Chinmay3042001/Weighing-Scale-Coaster/Coaster HDD.odt

HDD for “Coaster”

1. Block diagram of the coaster system

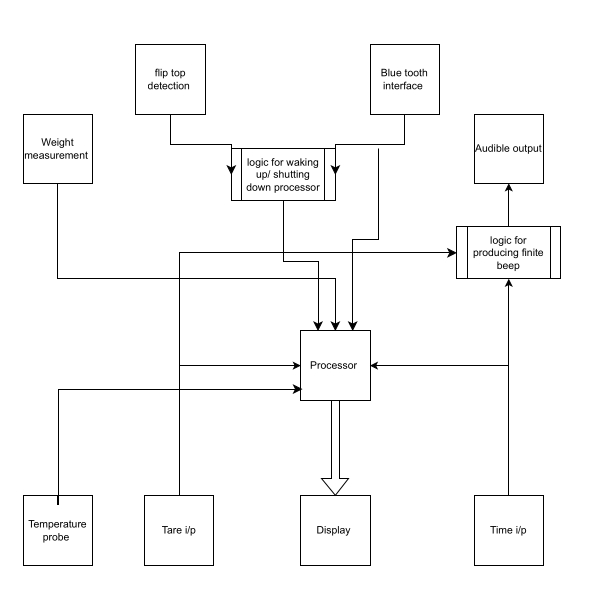
[picture p1: figure]

2. Requirements
  1. UI Inputs/Outputs :
    1. System should have two touch pads for the timer start and tare feature
    2. A flip top disc to start and shut down the system
    3. A dsiplay capable of conveying all details with required numeric precision as mandated by timing and weight measurement requirements
  2. Weight measurement
    1. Coaster shall be capable of weighing in the full scale range of 3000 grams
    2. Coaster shall be capable of weighing incremental changes of the order of 0.1 grams
    3. coaster shall have an acceptable error of 2% FS range.
  3. Temperature measurement requirements :
    1. The addon thermal probe in coaster shall be capable of measuring in a FS range of 0-110 deg C
    2. The thermal probe shall record data with minimum precision of 0.1deg C
    3. The tolerable error for the thermal probe shall be 1%
  4. Audio requirements
3. Design details
4. Source control

Weighing scale – “Coaster” Hardware design document
