Chinmay3042001/Weighing-Scale-Coaster/Weighing scale block diagram .drawio.pdf

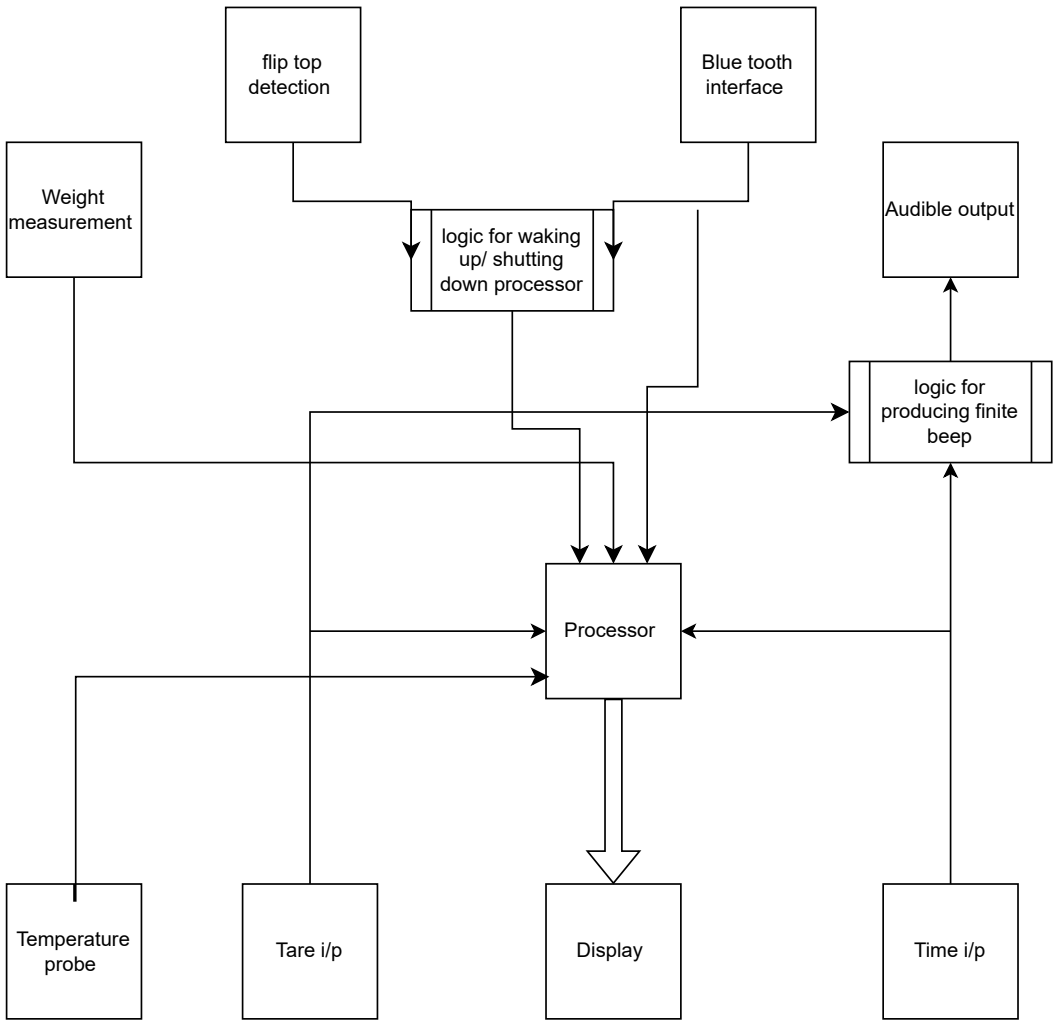
[picture p2: figure]
Processor; Tare i/p; Display; Time i/p; Audible output; flip top detection; Weight measurement; logic for producing finite beep; Temperature probe; Blue tooth interface; logic for waking up/ shutting; down processor
