Chinmay3042001/Weighing-Scale-Coaster/KiCAD/edge cuts for new mounting points.dxf

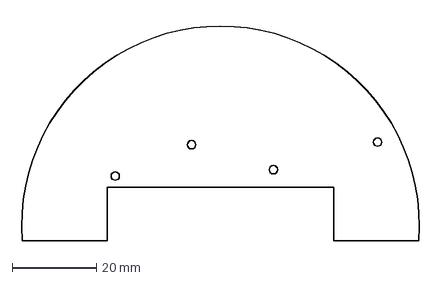
[picture p3: CAD file, 2025-10-31]
KiCAD/edge cuts for new mounting points.dxf
97.1 x 53.4 mm
