Chinmay3042001/Weighing-Scale-Coaster/KiCAD/WeighingScaleLibrary/LIB_74HC74D,653/74HC74D,653/3D/74HC74D,653.stp

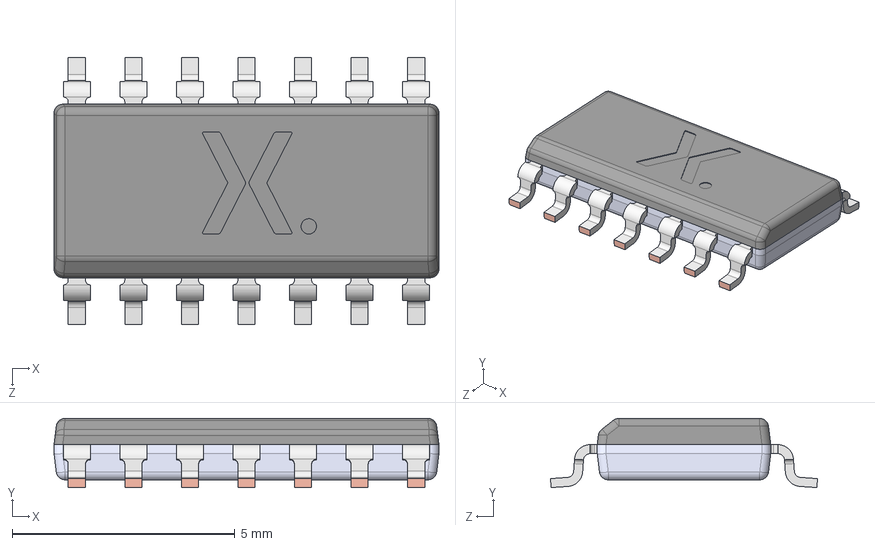
[picture p4: CAD file, 2025-10-02]
KiCAD/WeighingScaleLibrary/LIB_74HC74D,653/74HC74D,653/3D/74HC74D,653.stp
8.65 x 1.56 x 6.00 mm
SOT108 lower body
SOT108 upper body
SOT108-1 Lead
