Chinmay3042001/Weighing-Scale-Coaster/KiCAD/WeighingScaleLibrary/LIB_74LVC1G32W5-7/74LVC1G32W5-7/3D/74LVC1G32W5-7.stp

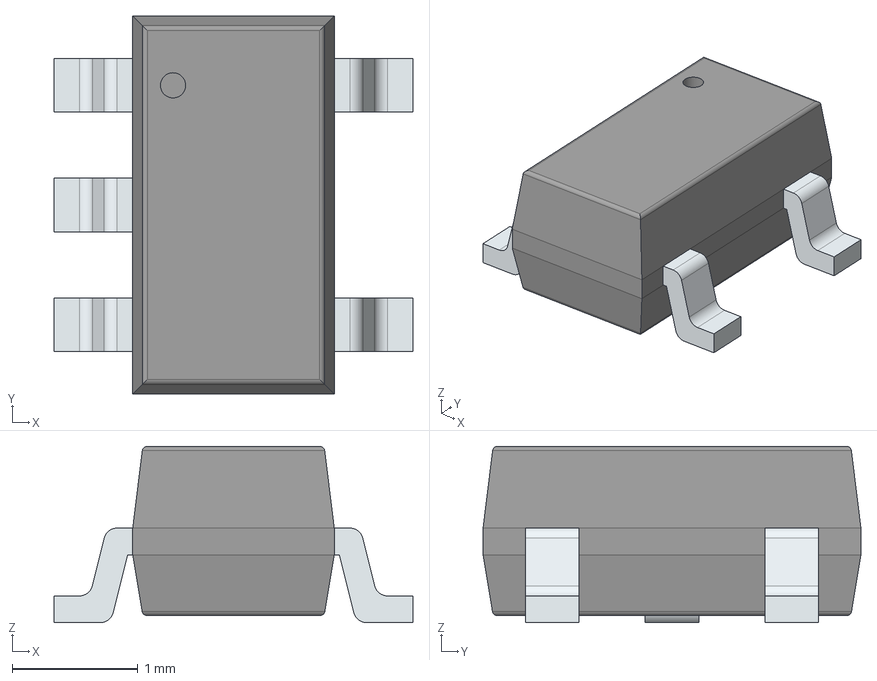
[picture p5: CAD file, 2026-01-18]
KiCAD/WeighingScaleLibrary/LIB_74LVC1G32W5-7/74LVC1G32W5-7/3D/74LVC1G32W5-7.stp
2.85 x 3.00 x 1.40 mm
PinsArrayL
PinsArrayR
