Chinmay3042001/Weighing-Scale-Coaster/KiCAD/WeighingScaleLibrary/LIB_CAP1203-1-SN/CAP1203-1-SN/3D/CAP1203-1-SN.stp

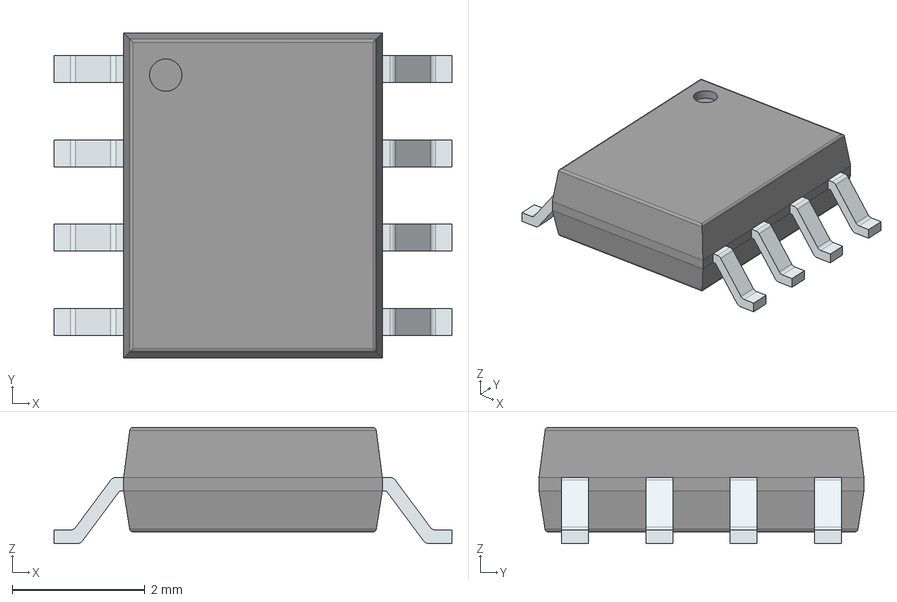
[picture p6: CAD file, 2025-12-10]
KiCAD/WeighingScaleLibrary/LIB_CAP1203-1-SN/CAP1203-1-SN/3D/CAP1203-1-SN.stp
6.00 x 4.90 x 1.75 mm
PinsArrayLR
