Chinmay3042001/Weighing-Scale-Coaster/KiCAD/WeighingScaleLibrary/LIB_JST_SM04B-SRSS-TB_LF__SN_/SM04B-SRSS-TB_LF__SN_/3D/SM04B-SRSS-TB_LF__SN_.stp

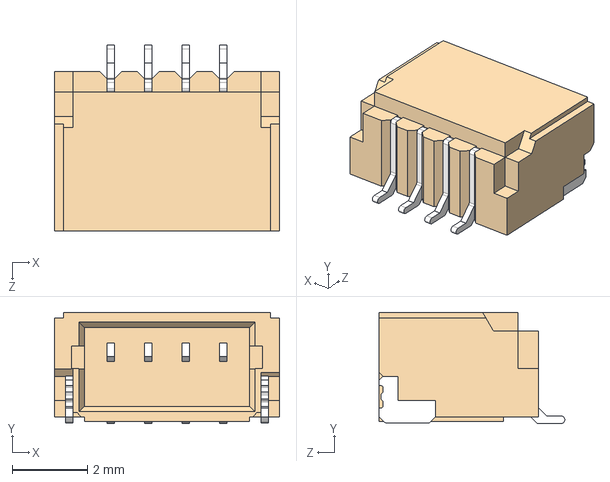
[picture p7: CAD file, 2025-10-10]
KiCAD/WeighingScaleLibrary/LIB_JST_SM04B-SRSS-TB_LF__SN_/SM04B-SRSS-TB_LF__SN_/3D/SM04B-SRSS-TB_LF__SN_.stp
6.00 x 2.96 x 4.95 mm
