Chinmay3042001/Weighing-Scale-Coaster/KiCAD/WeighingScaleLibrary/LIB_NX138AKR/NX138AKR.stp

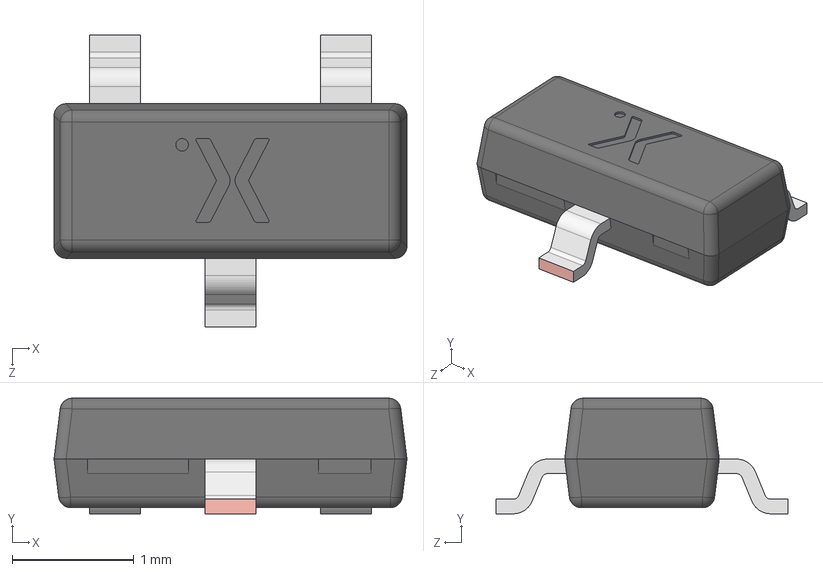
[picture p8: CAD file, 2025-10-28]
KiCAD/WeighingScaleLibrary/LIB_NX138AKR/NX138AKR.stp
2.90 x 0.95 x 2.40 mm
SOT23 lower body
SOT23 Lead x 3
SOT23 Upper body
