Chinmay3042001/Weighing-Scale-Coaster/KiCAD/WeighingScaleLibrary/LIB_PRT-12639 AUDIO/PRT-12639/3D/PRT-12639.stp

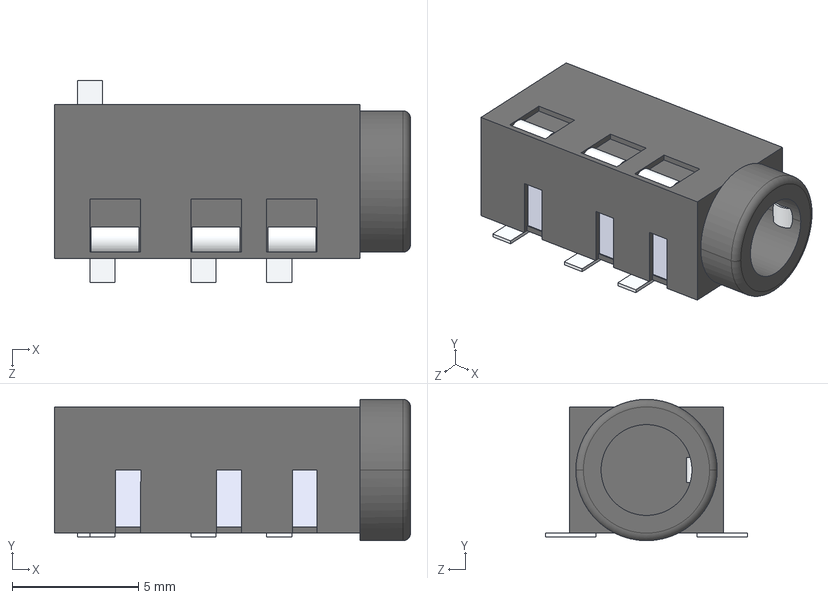
[picture p9: CAD file, 2025-10-10]
KiCAD/WeighingScaleLibrary/LIB_PRT-12639 AUDIO/PRT-12639/3D/PRT-12639.stp
14.1 x 5.60 x 8.00 mm
