Chinmay3042001/Weighing-Scale-Coaster/KiCAD/WeighingScaleLibrary/LIB_SFV14R-3STBE1HLF/SFV14R-3STBE1HLF/3D/SFV14R-3STBE1HLF.stp

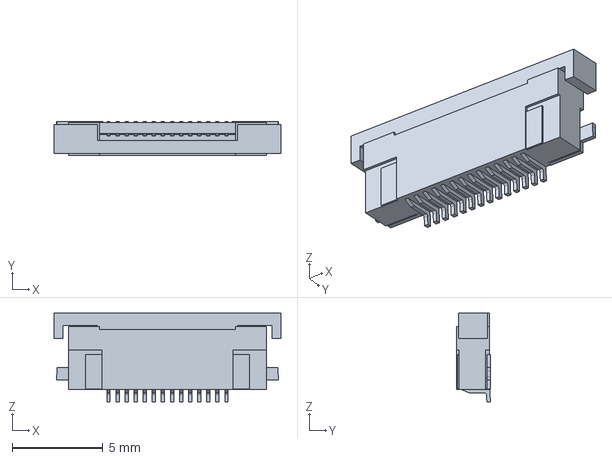
[picture p10: CAD file, 2025-10-04]
KiCAD/WeighingScaleLibrary/LIB_SFV14R-3STBE1HLF/SFV14R-3STBE1HLF/3D/SFV14R-3STBE1HLF.stp
12.5 x 1.87 x 4.90 mm
