Chinmay3042001/Weighing-Scale-Coaster/KiCAD/WeighingScaleLibrary/LIB_SN74LVC1G04DCKR/SN74LVC1G04DCKR/3D/SN74LVC1G04DCKR.stp

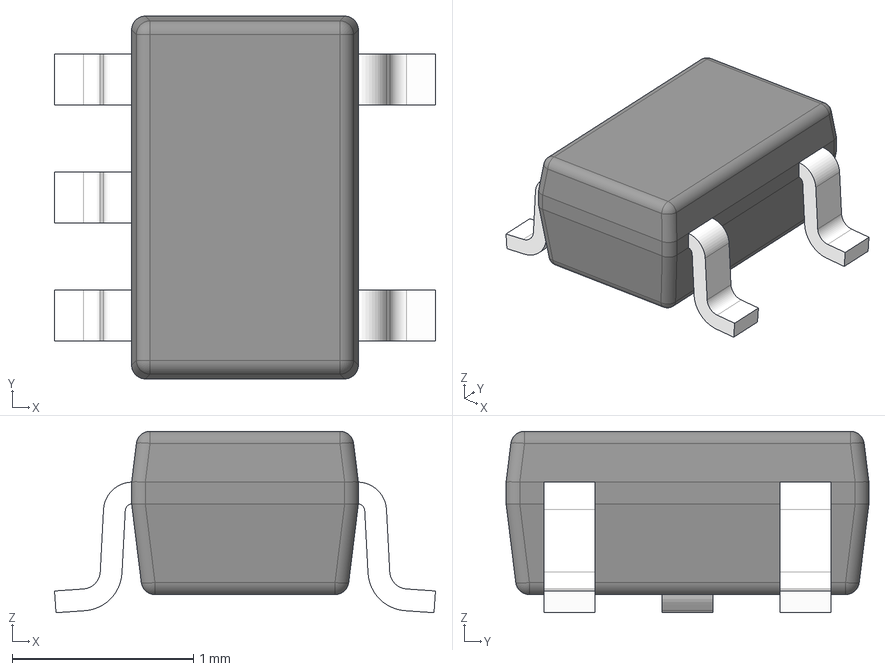
[picture p11: CAD file, 2025-10-10]
KiCAD/WeighingScaleLibrary/LIB_SN74LVC1G04DCKR/SN74LVC1G04DCKR/3D/SN74LVC1G04DCKR.stp
2.10 x 2.00 x 1.00 mm
BODY-SOT
LEAD-SOT x 5
PIN1-ID
