Chinmay3042001/Weighing-Scale-Coaster/KiCAD/WeighingScaleLibrary/LIB_SP720ABTG/SP720ABTG/3D/SP720ABTG.stp

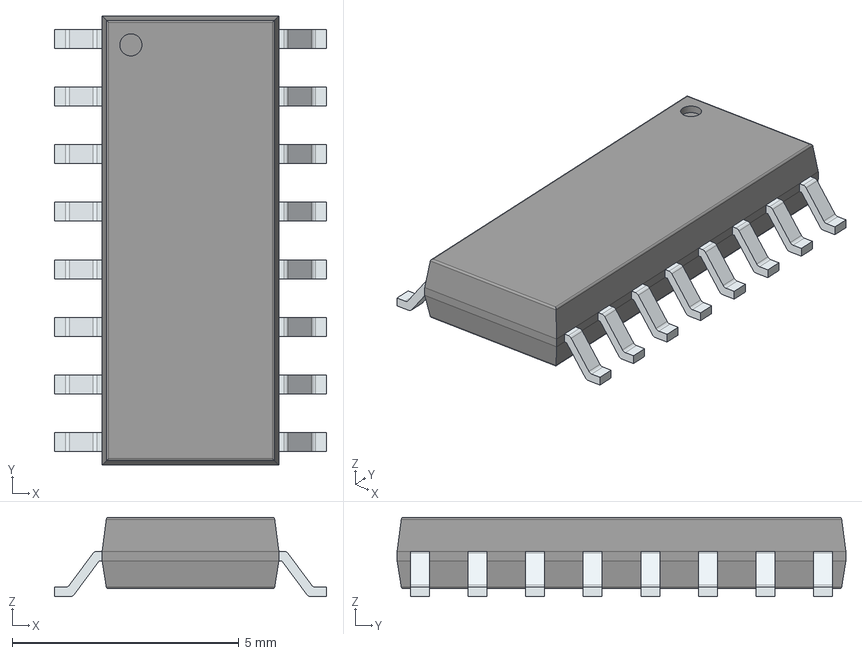
[picture p12: CAD file, 2025-10-01]
KiCAD/WeighingScaleLibrary/LIB_SP720ABTG/SP720ABTG/3D/SP720ABTG.stp
6.00 x 9.90 x 1.75 mm
PinsArrayLR
