Chinmay3042001/Weighing-Scale-Coaster/KiCAD/WeighingScaleLibrary/Library Files-20251007T151652Z-1-001/Library Files/seeedStudio_XIAO_Kicad/Seeed Studio XIAO ESP32-C6.step

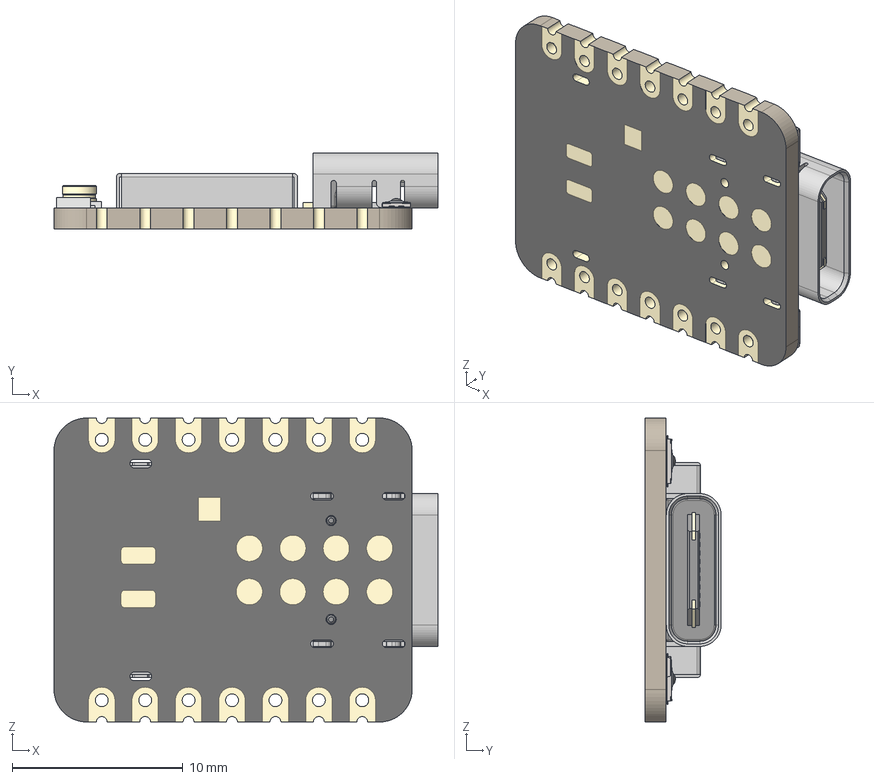
[picture p13: CAD file, 2025-10-10]
KiCAD/WeighingScaleLibrary/Library Files-20251007T151652Z-1-001/Library Files/seeedStudio_XIAO_Kicad/Seeed Studio XIAO ESP32-C6.step
22.5 x 4.46 x 17.8 mm
BOSS-EXTRUDE14_8_
BOSS-EXTRUDE7_4_
BOSS-EXTRUDE7_3_
BOSS-EXTRUDE14_4_
BOSS-EXTRUDE14_2_
BOSS-EXTRUDE14_11_
BOSS-EXTRUDE7_7_
BOSS-EXTRUDE14_9_
BOSS-EXTRUDE14_3_
BOSS-EXTRUDE14_7_
MIRROR2
BOSS-EXTRUDE14_5_
BOSS-EXTRUDE14_12_
BOSS-EXTRUDE7_8_
BOSS-EXTRUDE7_1_
BOSS-EXTRUDE14_10_
BOSS-EXTRUDE7_9_
BOSS-EXTRUDE14_6_
BOSS-EXTRUDE14_1_
BOSS-EXTRUDE7_6_
BOSS-EXTRUDE7_2_
CUT-EXTRUDE5
BOSS-EXTRUDE7_5_
U.FL Connector v1
Shield
SKTAAAE010 x 2
KH5220-A36 (Ceramic Antenna) v2
