Chinmay3042001/Weighing-Scale-Coaster/KiCAD/WeighingScaleLibrary/Library Files-20251007T151652Z-1-001/Library Files/TTP223-BA6 (1)/TTP223-BA6.step

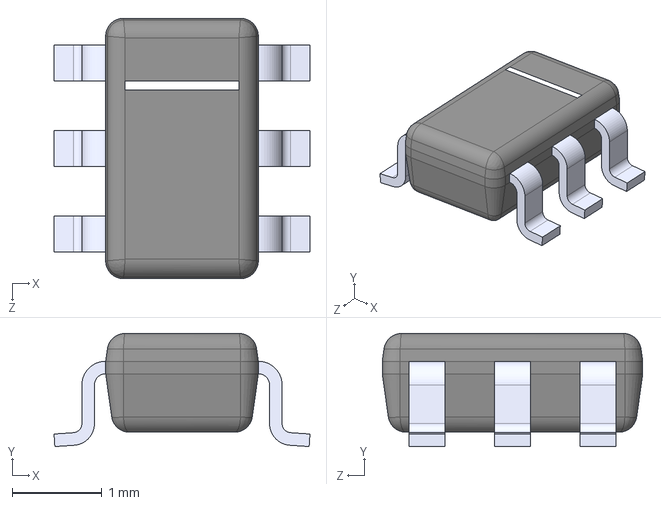
[picture p14: CAD file, 2025-10-10]
KiCAD/WeighingScaleLibrary/Library Files-20251007T151652Z-1-001/Library Files/TTP223-BA6 (1)/TTP223-BA6.step
2.85 x 1.26 x 2.90 mm
