Chinmay3042001/Weighing-Scale-Coaster/KiCAD/DXF no center marks.dxf

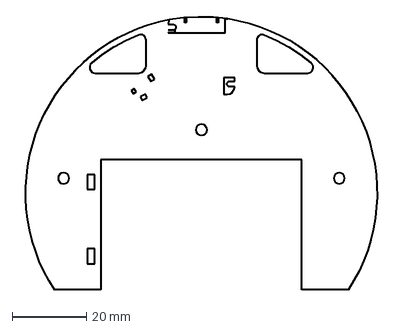
[picture p15: CAD file, 2025-10-18]
KiCAD/DXF no center marks.dxf
99.5 x 73.6 mm
