Chinmay3042001/Weighing-Scale-Coaster/KiCAD/touchpad_boundary.dxf

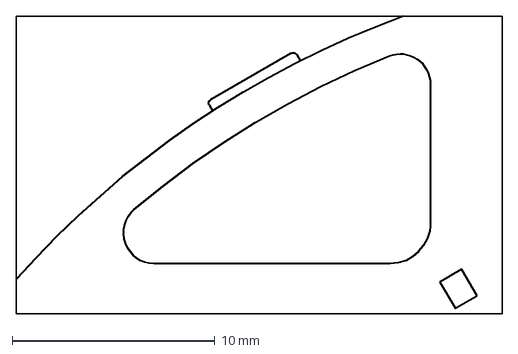
[picture p16: CAD file, 2025-10-18]
KiCAD/touchpad_boundary.dxf
24.0 x 14.7 mm
