Chinmay3042001/Weighing-Scale-Coaster/KiCAD/placement guide.dxf

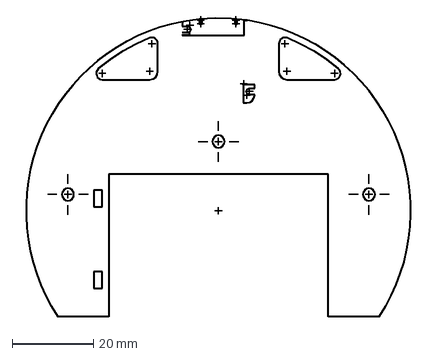
[picture p17: CAD file, 2025-10-06]
KiCAD/placement guide.dxf
99.5 x 73.7 mm
