Chinmay3042001/Weighing-Scale-Coaster/KiCAD/card_edge.dxf

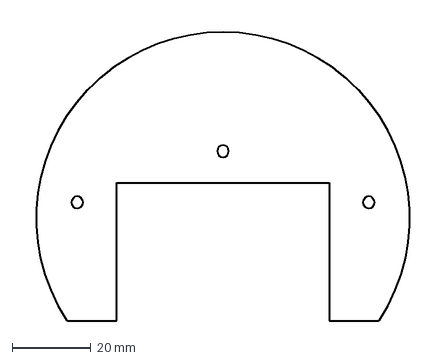
[picture p18: CAD file, 2025-10-06]
KiCAD/card_edge.dxf
105.0 x 77.2 mm
