Chinmay3042001/Weighing-Scale-Coaster/(list of files, cad)

Other CAD files:
KiCAD/WeighingScaleLibrary/LIB_MAX6675ISA+T/MAX6675ISA+T/3D/MAX6675ISA+T.stp
KiCAD/WeighingScaleLibrary/Library Files-20251007T151652Z-1-001/Library Files/LIB_MAX6675ISA+T/MAX6675ISA+T/3D/MAX6675ISA+T.stp
KiCAD/WeighingScaleLibrary/TTP223-BA6--3DModel-STEP-269445.STEP
KiCAD/WeighingScaleLibrary/LIB_74HC74D,653/74HC74D,653/Allegro/soic127p600x175-14n.psm
KiCAD/WeighingScaleLibrary/LIB_74HC74D,653/74HC74D,653/DEHDL/74hc74d_653/chips/chips.prt
KiCAD/WeighingScaleLibrary/LIB_74LVC1G08GW/74LVC1G08GW/Allegro/sot65p212x110-5n.psm
KiCAD/WeighingScaleLibrary/LIB_74LVC1G08GW/74LVC1G08GW/DEHDL/74lvc1g08gw/chips/chips.prt
KiCAD/WeighingScaleLibrary/LIB_74LVC1G32W5-7/74LVC1G32W5-7/Allegro/sot95p285x140-5n.psm
KiCAD/WeighingScaleLibrary/LIB_74LVC1G32W5-7/74LVC1G32W5-7/DEHDL/74lvc1g32w5_7/chips/chips.prt
KiCAD/WeighingScaleLibrary/LIB_74LVC1G79GW,125/74LVC1G79GW,125/Allegro/sot65p212x110-5n.psm
KiCAD/WeighingScaleLibrary/LIB_74LVC1G79GW,125/74LVC1G79GW,125/DEHDL/74lvc1g79gw_125/chips/chips.prt
KiCAD/WeighingScaleLibrary/LIB_APS11753KMDALX-9PL5/APS11753KMDALX-9PL5/3D/APS11753KMDALX-9PL5.stp
KiCAD/WeighingScaleLibrary/LIB_CAP1203-1-SN/CAP1203-1-SN/Allegro/soic127p600x175-8n.psm
KiCAD/WeighingScaleLibrary/LIB_CAP1203-1-SN/CAP1203-1-SN/DEHDL/cap1203_1_sn/chips/chips.prt
KiCAD/WeighingScaleLibrary/LIB_NX138AKR (2)/NX138AKR/Allegro/sot95p230x110-3n.psm
KiCAD/WeighingScaleLibrary/LIB_NX138AKR (2)/NX138AKR/DEHDL/nx138akr/chips/chips.prt
KiCAD/WeighingScaleLibrary/LIB_SFV14R-3STBE1HLF/SFV14R-3STBE1HLF/Allegro/sfv14r3stbe1hlf.psm
KiCAD/WeighingScaleLibrary/LIB_SFV14R-3STBE1HLF/SFV14R-3STBE1HLF/DEHDL/sfv14r_3stbe1hlf/chips/chips.prt
KiCAD/WeighingScaleLibrary/LIB_SN74LVC1G04DCKR/SN74LVC1G04DCKR/Allegro/sot65p210x110-5n.psm
KiCAD/WeighingScaleLibrary/LIB_SN74LVC1G04DCKR/SN74LVC1G04DCKR/DEHDL/sn74lvc1g04dckr/chips/chips.prt
KiCAD/WeighingScaleLibrary/LIB_SP720ABTG/SP720ABTG/Allegro/soic127p600x175-16n.psm
KiCAD/WeighingScaleLibrary/LIB_SP720ABTG/SP720ABTG/DEHDL/sp720abtg/chips/chips.prt
KiCAD/WeighingScaleLibrary/Library Files-20251007T151652Z-1-001/Library Files/LIB_APS11753KMDALX-9PL5/APS11753KMDALX-9PL5/3D/APS11753KMDALX-9PL5.stp
