Chinmay3042001/Weighing-Scale-Coaster/KiCAD/ws_schematic_draft1.pdf

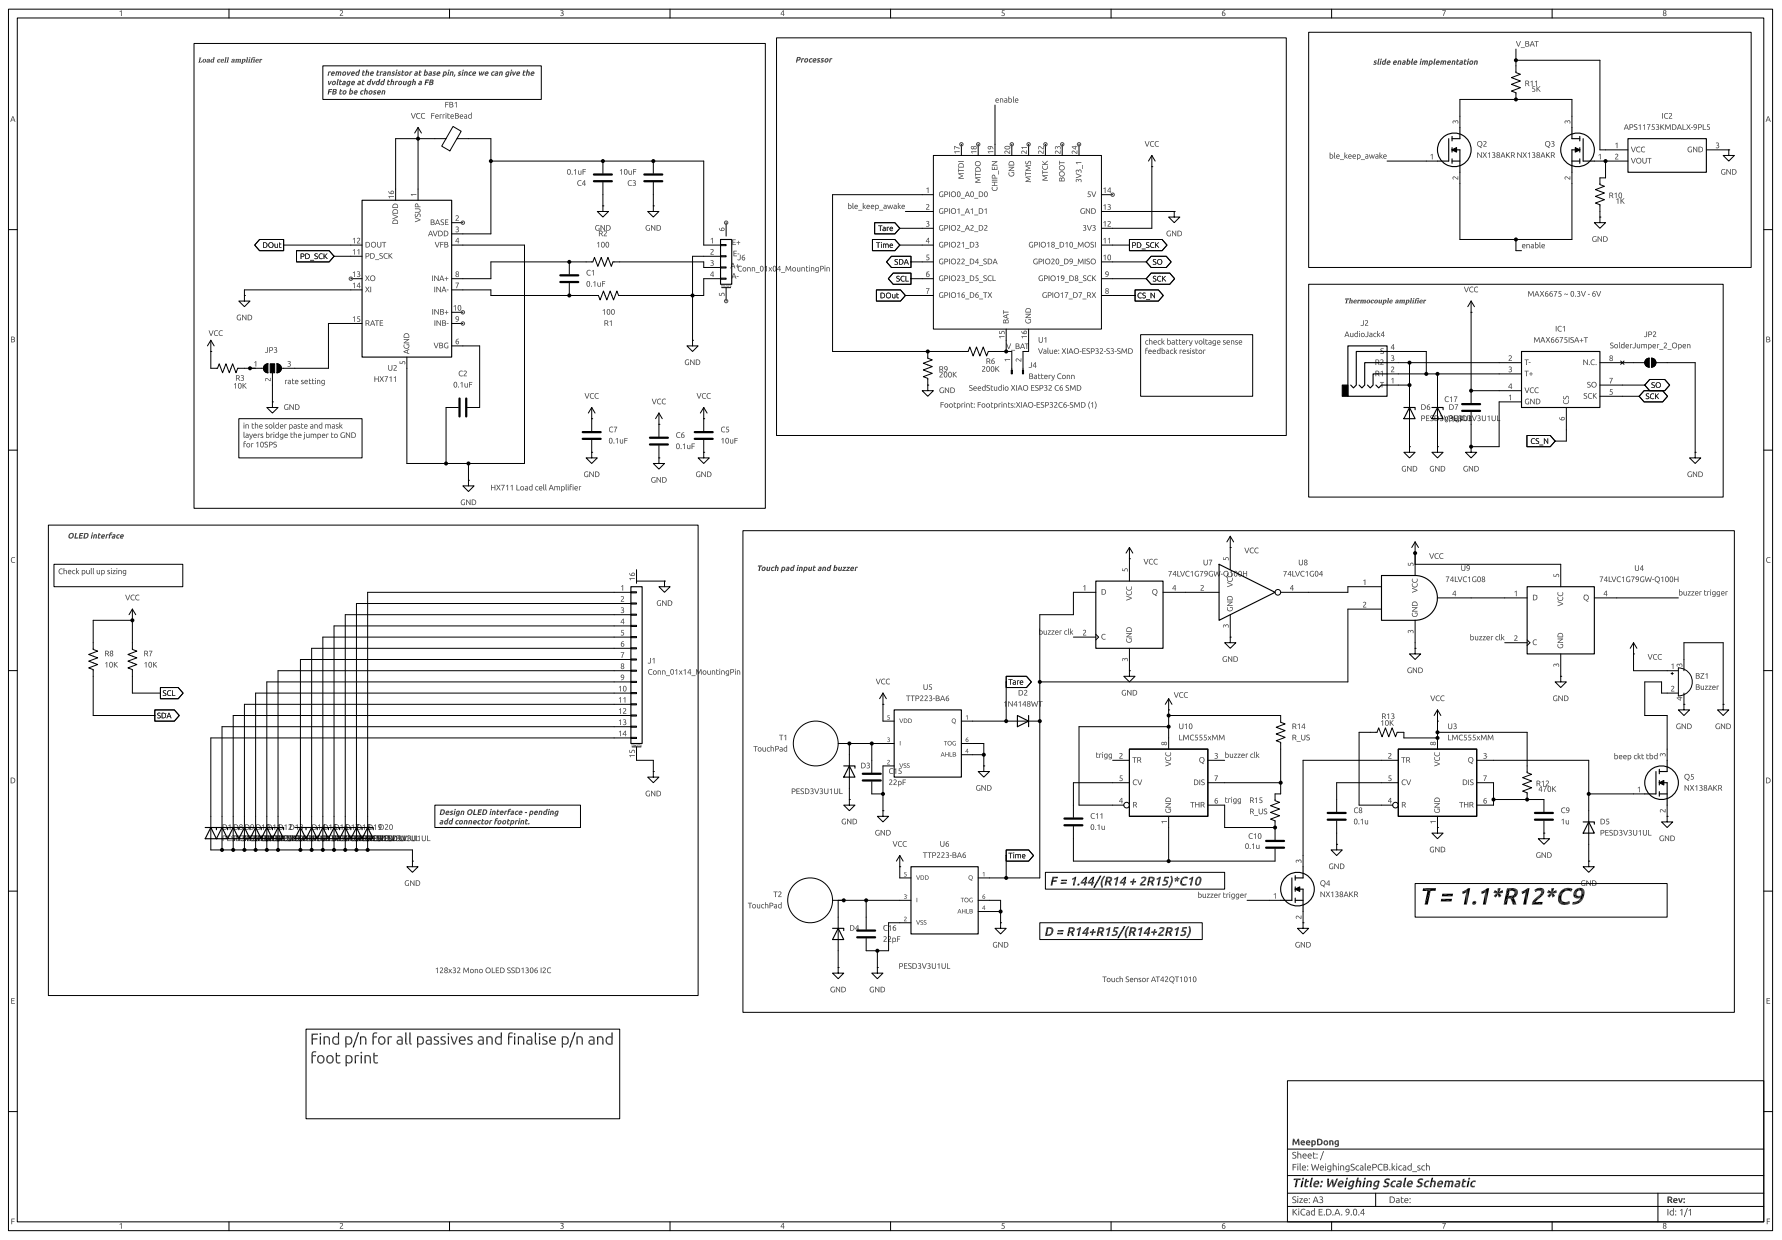
[picture p19: page 1]
