Chinmay3042001/Weighing-Scale-Coaster/(list of files, drawings)

Other design files:
KiCAD/WeighingScaleLibrary/LIB_74HC74D,653/74HC74D,653/Altium/74HC74D_653.SchLib
KiCAD/WeighingScaleLibrary/LIB_74HC74D,653/74HC74D,653/Altium/SOIC127P600X175-14N.PcbLib
KiCAD/WeighingScaleLibrary/LIB_74LVC1G08GW/74LVC1G08GW/Altium/74LVC1G08GW.SchLib
KiCAD/WeighingScaleLibrary/LIB_74LVC1G08GW/74LVC1G08GW/Altium/SOT65P212X110-5N.PcbLib
KiCAD/WeighingScaleLibrary/LIB_74LVC1G32W5-7/74LVC1G32W5-7/Altium/74LVC1G32W5-7.SchLib
KiCAD/WeighingScaleLibrary/LIB_74LVC1G32W5-7/74LVC1G32W5-7/Altium/SOT95P285X140-5N.PcbLib
KiCAD/WeighingScaleLibrary/LIB_74LVC1G79GW,125/74LVC1G79GW,125/Altium/74LVC1G79GW_125.SchLib
KiCAD/WeighingScaleLibrary/LIB_74LVC1G79GW,125/74LVC1G79GW,125/Altium/SOT65P212X110-5N.PcbLib
KiCAD/WeighingScaleLibrary/LIB_CAP1203-1-SN/CAP1203-1-SN/Altium/CAP1203-1-SN.SchLib
KiCAD/WeighingScaleLibrary/LIB_CAP1203-1-SN/CAP1203-1-SN/Altium/SOIC127P600X175-8N.PcbLib
KiCAD/WeighingScaleLibrary/LIB_NX138AKR (2)/NX138AKR/Altium/NX138AKR.SchLib
KiCAD/WeighingScaleLibrary/LIB_NX138AKR (2)/NX138AKR/Altium/SOT95P230X110-3N.PcbLib
KiCAD/WeighingScaleLibrary/LIB_SFV14R-3STBE1HLF/SFV14R-3STBE1HLF/Altium/SFV14R3STBE1HLF.PcbLib
KiCAD/WeighingScaleLibrary/LIB_SFV14R-3STBE1HLF/SFV14R-3STBE1HLF/Altium/SFV14R-3STBE1HLF.SchLib
KiCAD/WeighingScaleLibrary/LIB_SN74LVC1G04DCKR/SN74LVC1G04DCKR/Altium/SN74LVC1G04DCKR.SchLib
KiCAD/WeighingScaleLibrary/LIB_SN74LVC1G04DCKR/SN74LVC1G04DCKR/Altium/SOT65P210X110-5N.PcbLib
KiCAD/WeighingScaleLibrary/LIB_SP720ABTG/SP720ABTG/Altium/SOIC127P600X175-16N.PcbLib
KiCAD/WeighingScaleLibrary/LIB_SP720ABTG/SP720ABTG/Altium/SP720ABTG.SchLib
