Chinmay3042001/Weighing-Scale-Coaster/KiCAD/WeighingScalePCB/WeighingScalePCB.kicad_pcb

## KiCad design KiCAD/WeighingScalePCB/WeighingScalePCB.kicad_pcb (2026-01-18)

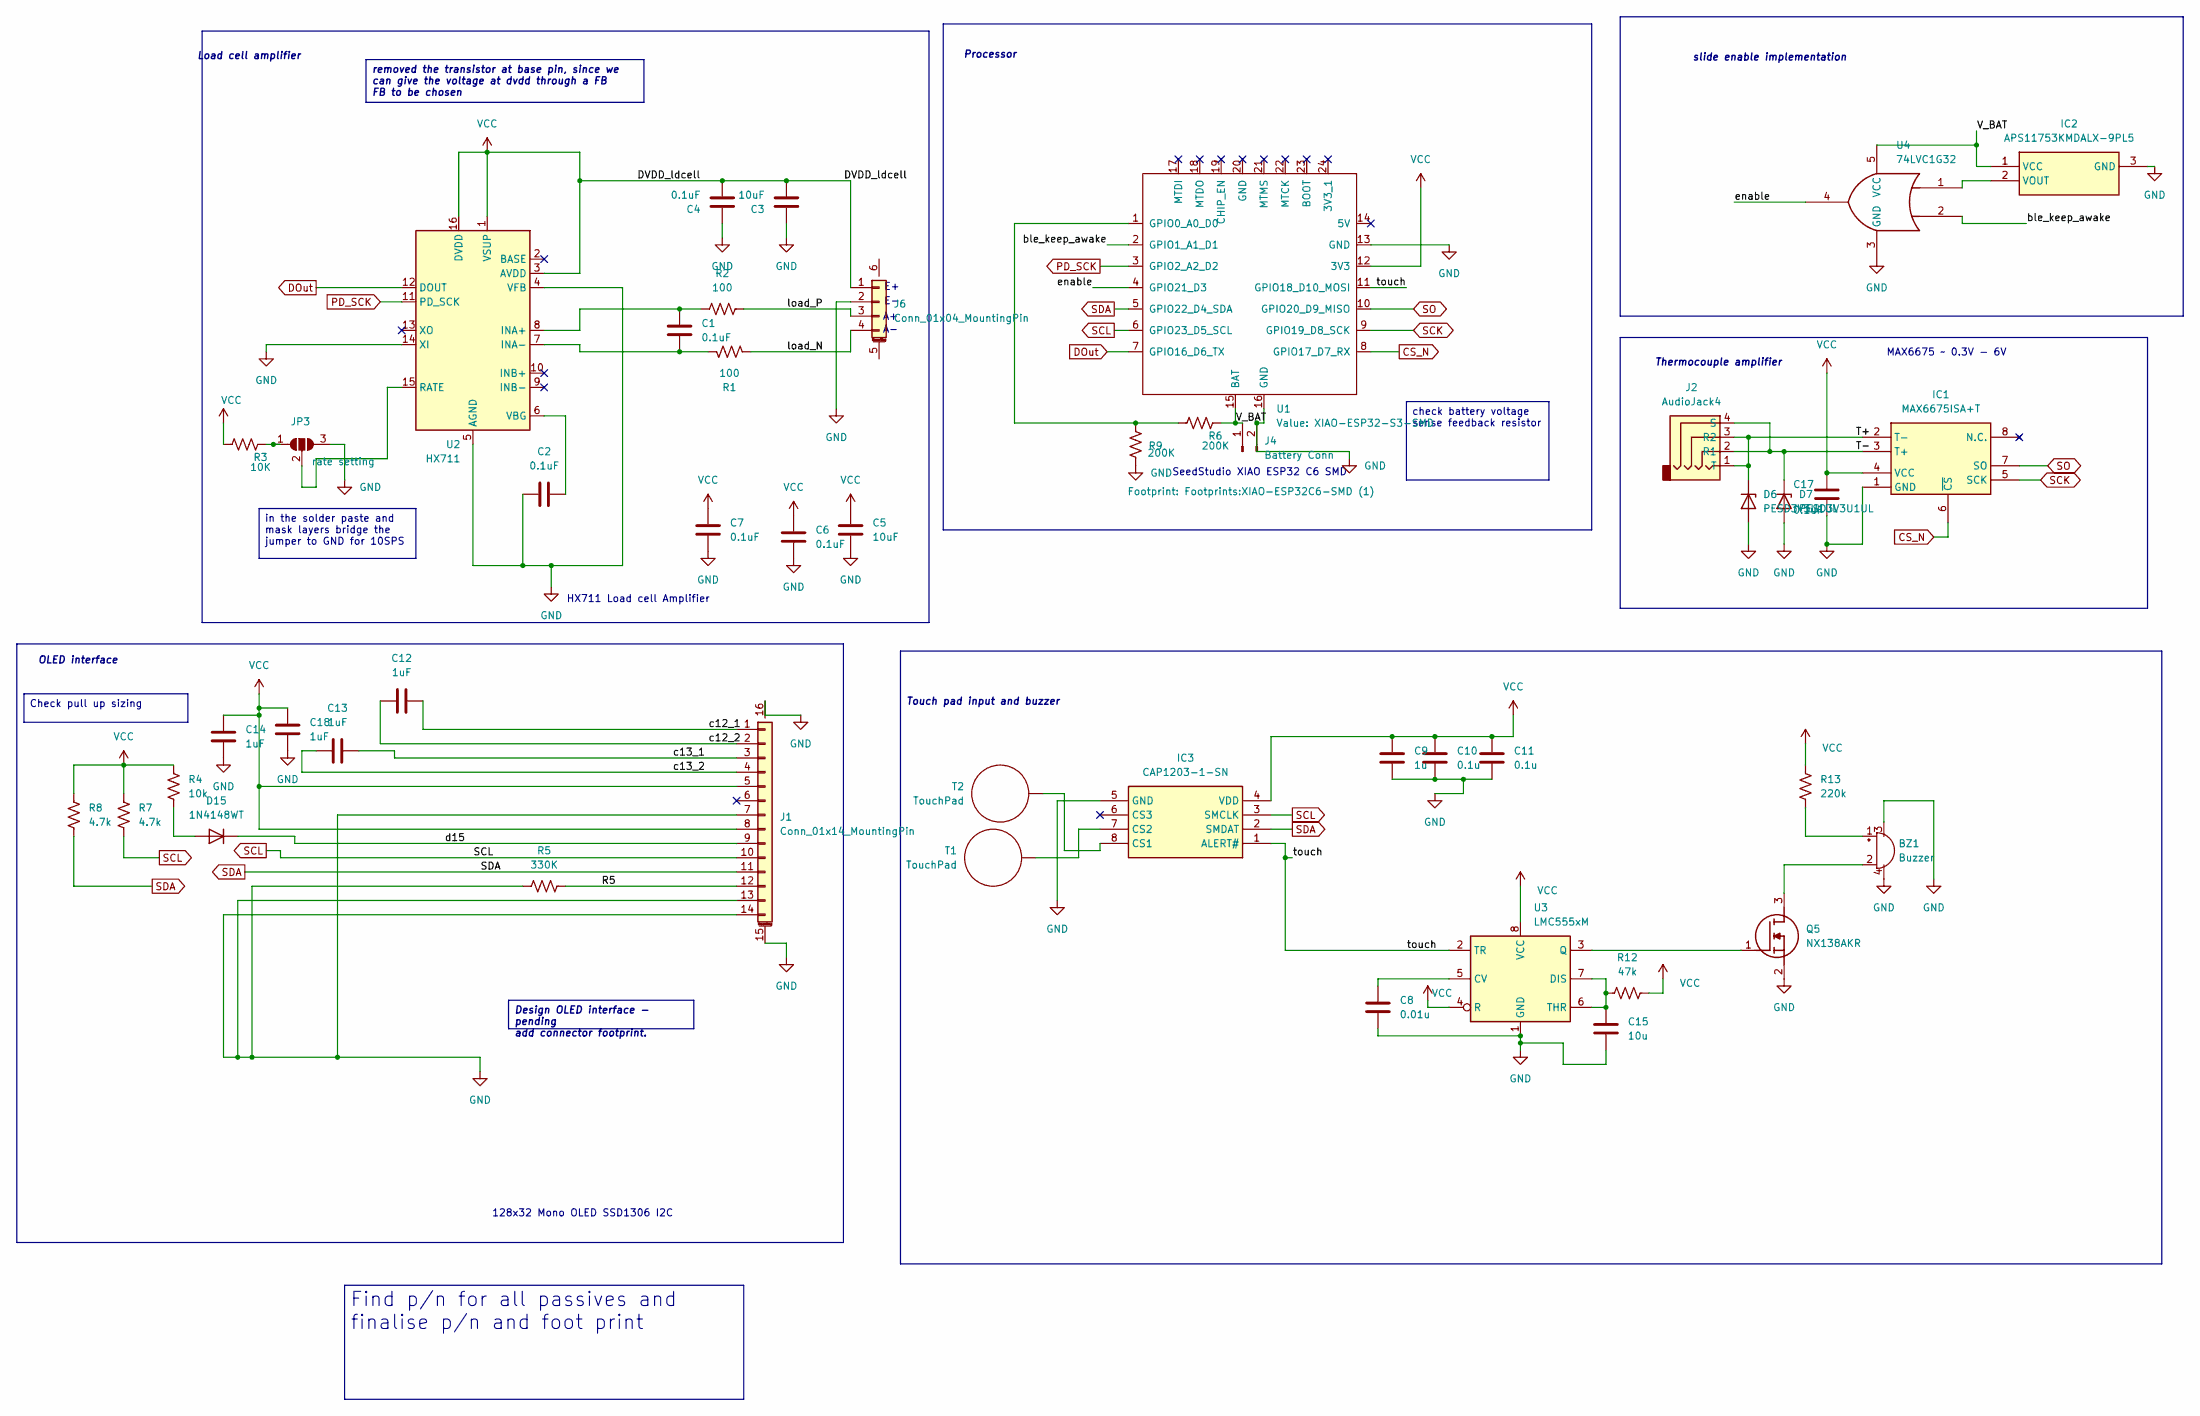
[picture p20: schematic WeighingScalePCB.kicad_sch, Weighing Scale Schematic]

Parts:
BZ1: Buzzer; CL7525A_buzzer
C1, C2, C4, C6, C7, C17: 0.1uF; C_0603_1608Metric
C3, C5: 10uF; C_0603_1608Metric
C8: 0.01u; C_0603_1608Metric
C9: 1u; C_0603_1608Metric
C10, C11: 0.1u; C_0603_1608Metric
C12, C13, C14, C18: 1uF; C_0603_1608Metric
C15: 10u; C_0603_1608Metric
D6, D7: PESD3V3U1UL; D_SOD-882
D15: 1N4148WT; D_SOD-523
IC1: MAX6675ISA+T; SOIC127P600X175-8N_MAX6675; Mouser Part Number 700-MAX6675ISAT
IC2: APS11753KMDALX-9PL5; SOT95P240X115-3N_Hall effect; Mouser Part Number 250-APS11753KMD-9PL5
IC3: CAP1203-1-SN; CAP1203_SOIC127P600X175-8N; Mouser Part Number 579-CAP1203-1-SN
J1: Conn_01x14_MountingPin; SFV14R3STBE1HLF_oled_conn
J2: AudioJack4; PRT12639_thermocouple_conn
J4: Battery Conn; PinHeader_2x01_P2.00mm_Vertical_SMD
J6: Conn_01x04_MountingPin; SM04B-SRSS-TB_LFSN_
JP3: rate setting; SolderJumper-3_P1.3mm_Open_RoundedPad1.0x1.5mm
Q5: NX138AKR; SOT95P230X110-3N; Mouser Part Number 771-NX138AKR
R1, R2: 100; R_0603_1608Metric
R3: 10K; R_0603_1608Metric
R4: 10k; R_0402_1005Metric
R5: 330K; R_0402_1005Metric
R6, R9: 200K; R_0603_1608Metric
R7, R8: 4.7k; R_0603_1608Metric
R12: 47k; R_0603_1608Metric
R13: 220k; R_0603_1608Metric
T1: TouchPad; touchpad
T2: TouchPad; touchpad 2
U1: XIAO-ESP32-S3-SMD; XIAO-ESP32C6-SMD (1)
U2: HX711; SOIC-16_3.9x9.9mm_P1.27mm
U3: LMC555xM; SOIC-8_3.9x4.9mm_P1.27mm
U4: 74LVC1G32; SOT95P285X140-5N

Connections:
/R5: J1.12, R5.2
/T+: D6.1 (K), IC1.2 (T-), J2.1 (T), J2.3 (R2)
/T-: D7.1 (K), IC1.3 (T+), J2.2 (R1), J2.4 (S)
/V_BAT: IC2.1 (VCC), J4.1, R6.1, U1.15 (BAT), U4.5 (VCC)
/ble_keep_awake: U1.2 (GPIO1_A1_D1), U4.2
/c12_1: C12.2, J1.1
/c12_2: C12.1, J1.2
/c13_1: C13.2, J1.3
/c13_2: C13.1, J1.4
/d15: D15.1 (K), J1.9
/enable: U1.4 (GPIO21_D3), U4.4
/load_N: J6.4, R1.1
/load_P: J6.3, R2.1
/touch: IC3.1 (ALERT#), U1.11 (GPIO18_D10_MOSI), U3.2 (TR)
CS_N: IC1.6 (~CS), U1.8 (GPIO17_D7_RX)
DOut: U1.7 (GPIO16_D6_TX), U2.12 (DOUT)
GND: BZ1.3 (+), BZ1.4 (+), C2.1, C3.1, C4.1, C5.2, C6.2, C7.2, C8.2, C9.2, C10.2, C11.2, C14.1, C15.2, C17.1, C18.1, D6.2 (A), D7.2 (A), IC1.1 (GND), IC2.3 (GND), IC3.5 (GND), J1.7, J1.13, J1.14, J1.15 (MountPin), J1.16 (MountPin), J4.2, J6.2, JP3.3 (B), Q5.2 (S), R5.1, R9.2, U1.13 (GND), U1.16 (GND), U2.4 (VFB), U2.5 (AGND), U2.14 (XI), U3.1 (GND), U4.3 (GND)
unnamed: BZ1.1 (+), R13.1
unnamed: BZ1.2 (-), Q5.3 (D)
unnamed: D15.2 (A), R4.2
unnamed: IC2.2 (VOUT), U4.1
unnamed: IC3.8 (CS1), T2.T2 (Pad)
unnamed: IC3.7 (CS2), T1.T1 (Pad)
unnamed: JP3.1 (A), R3.1
unnamed: JP3.2 (C), U2.15 (RATE)
unnamed: Q5.1 (G), U3.3 (Q)
unnamed: R6.2, R9.1, U1.1 (GPIO0_A0_D0)
unnamed: C1.1, R2.2, U2.8 (INA+)
unnamed: C1.2, R1.2, U2.7 (INA-)
unnamed: C2.2, U2.6 (VBG)
unnamed: C8.1, U3.5 (CV)
unnamed: C15.1, R12.1, U3.6 (THR), U3.7 (DIS)
PD_SCK: U1.3 (GPIO2_A2_D2), U2.11 (PD_SCK)
SCK: IC1.5 (SCK), U1.9 (GPIO19_D8_SCK)
SCL: IC3.3 (SMCLK), J1.10, R7.2, U1.6 (GPIO23_D5_SCL)
SDA: IC3.2 (SMDAT), J1.11, R8.2, U1.5 (GPIO22_D4_SDA)
SO: IC1.7 (SO), U1.10 (GPIO20_D9_MISO)
VCC: C3.2, C4.2, C5.1, C6.1, C7.1, C9.1, C10.1, C11.1, C14.2, C17.2, C18.2, IC1.4 (VCC), IC3.4 (VDD), J1.5, J1.8, J6.1, R3.2, R4.1, R7.1, R8.1, R12.2, R13.2, U1.12 (3V3), U2.1 (VSUP), U2.3 (AVDD), U2.16 (DVDD), U3.4 (R), U3.8 (VCC)

Notes on the sheet:
HX711 Load cell Amplifier
MAX6675 ~ 0.3V - 6V
slide enable implementation
OLED interface
Load cell amplifier
SeedStudio XIAO ESP32 C6 SMD
Thermocouple amplifier
Touch pad input and buzzer
Processor
128x32 Mono OLED SSD1306 I2C
removed the transistor at base pin, since we can give the voltage at dvdd through a FB FB to be chosen
Find p/n for all passives and finalise p/n and foot print
in the solder paste and mask layers bridge the jumper to GND for 10SPS
Design OLED interface - pending add connector footprint.
check battery voltage sense feedback resistor
Check pull up sizing

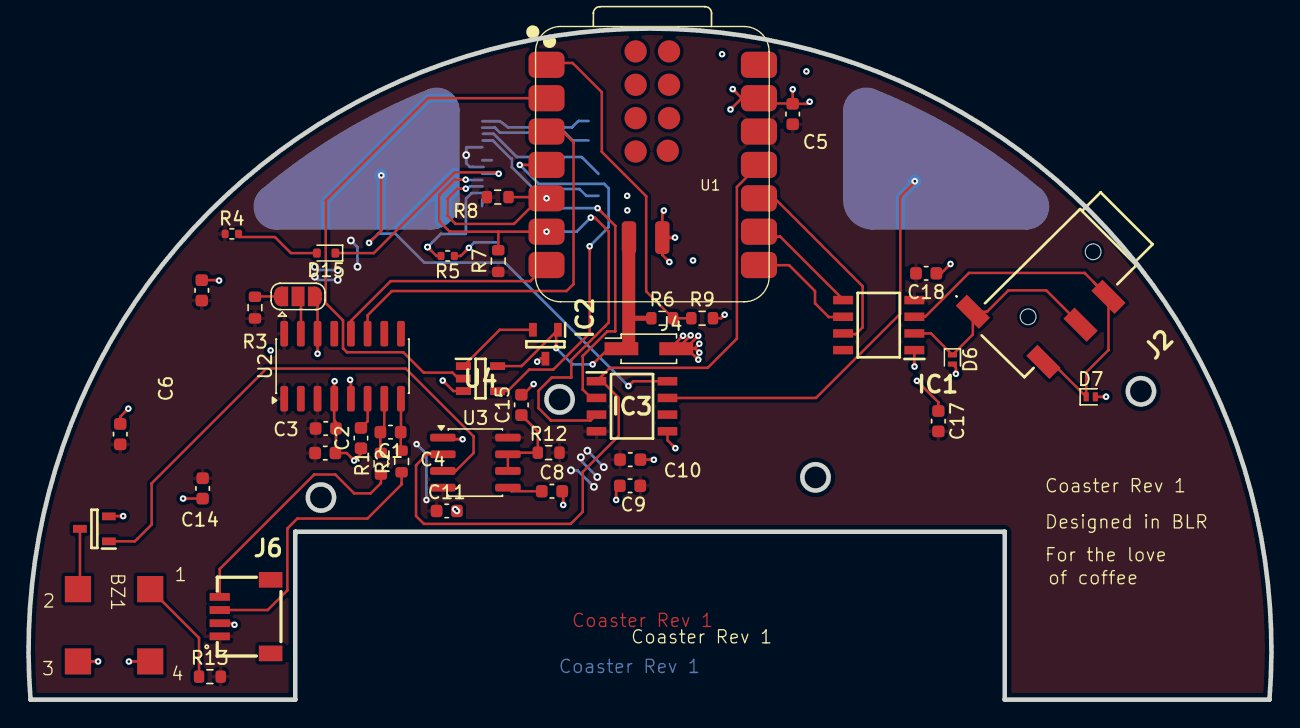
[picture p21: board WeighingScalePCB.kicad_pcb from above]

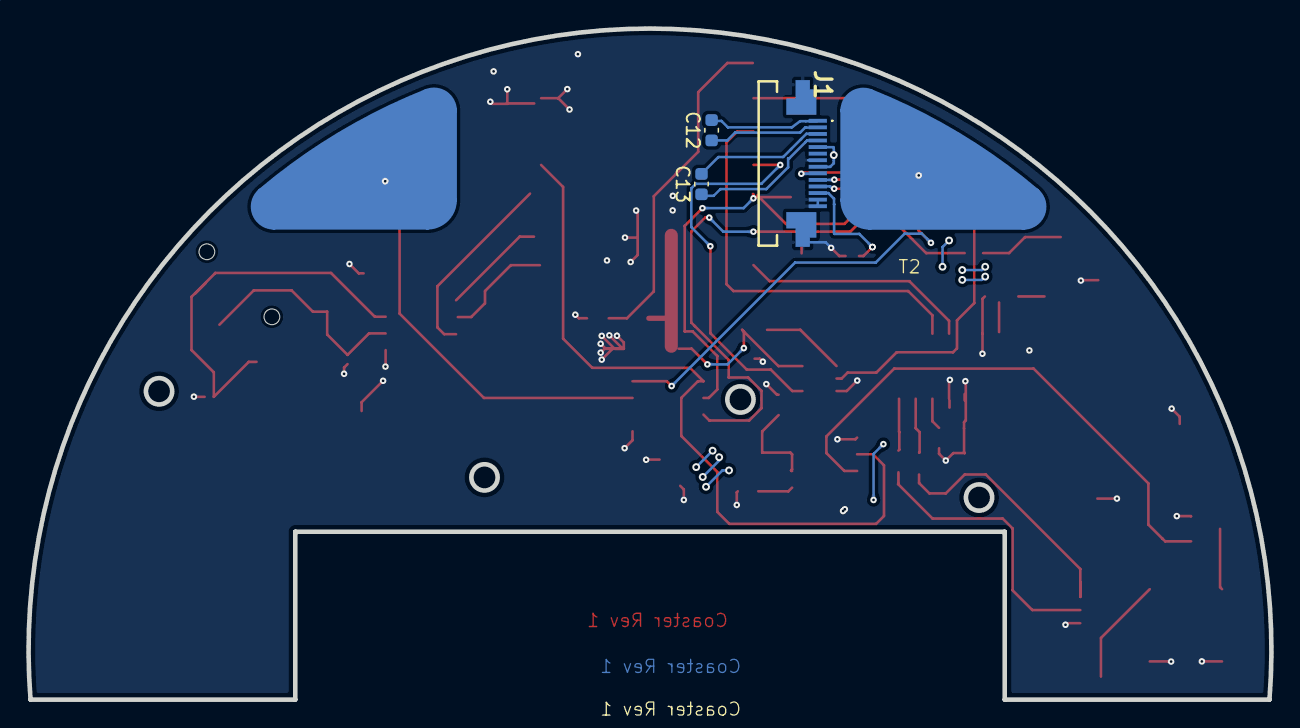
[picture p22: board WeighingScalePCB.kicad_pcb from below]

Board: 2 copper layers, 94.6 x 51.1 mm, 47 parts (3 on the bottom side), 38 nets.
