Chinmay3042001/Weighing-Scale-Coaster/(commit log)

2025-10-01 updated connectors, added chip en circuit
    [EDI2CAP.CFG, SOIC127P600X175-16N.PcbLib, SP720ABTG.SchLib, SP720ABTG.stp, WeighingScalePCB.kicad_sch, chips.prt, soic127p600x175-16n.psm]
2025-10-01 1. Added buzzer beep implementation - to be reviewed and calculations to be finalised 2. cleaned up schematic 3. added comments of pending activities
    [WeighingScalePCB.kicad_sch]
2025-10-01 Added half millisecond beep
    [WeighingScalePCB.kicad_sch]
2025-10-02 Added notes for buzzer ckt added design note for hx711
    [WeighingScalePCB.kicad_sch]
2025-10-02 added trigger implementation for buzzer
    [WeighingScalePCB.csv]
2025-10-02 added components to library
    [74HC74D,653.stp, 74HC74D_653.SchLib, EDI2CAP.CFG, SOIC127P600X175-14N.PcbLib, TTP223-BA6--3DModel-STEP-269445.STEP, chips.prt, soic127p600x175-14n.psm]
2025-10-02 Added touch pad implementation
    [WeighingScalePCB.kicad_sch]
2025-10-03 replaced ne555 with lmc555 since we are operating at 3.3v
    [WeighingScalePCB.kicad_sch]
2025-10-03 1. added TOG = 0 and AHLB = 0 for direct mode and active high setting. 2. made all digital ICs LVCMOS
    [WeighingScalePCB.kicad_sch]
2025-10-04 made all passives 0603, added design notes, added fb between avdd and dvdd in hx711, removed transistor in hx711.
    [EDI2CAP.CFG, SFV14R-3STBE1HLF.SchLib, SFV14R-3STBE1HLF.stp, SFV14R3STBE1HLF.PcbLib, WeighingScalePCB.kicad_sch, chips.prt, sfv14r3stbe1hlf.psm]
2025-10-05 added DXF pcb shape file
    [pcb outline.dxf]
2025-10-05 imported schematic footprints to layout, noted list of missing fp
    [WeighingScalePCB.kicad_pcb]
2025-10-06 Added flowchart for board and dxf in the layout for card edge and placement of components
    [WeighingScalePCB.kicad_pcb, card_edge.dxf, pcb outline.dxf, placement guide.dxf]
2025-10-06 added more specific p/n for d flip flop
    [WeighingScalePCB.kicad_sch]
2025-10-06 Corrected time and tare orring circuit
    [WeighingScalePCB.kicad_pcb, WeighingScalePCB.kicad_sch]
2025-10-10 assigned footprints
    [APS11753KMDALX-9PL5.stp, MAX6675ISA+T.stp, PRT-12639.stp, SM04B-SRSS-TB_LF__SN_.stp, Seeed Studio XIAO ESP32-C6.step, TTP223-BA6--3DModel-STEP-269445.STEP, TTP223-BA6.step, WeighingScalePCB.kicad_pcb]
2025-10-10 added toucpad and all fps, only ferrite selection pending
    [74LVC1G08GW.SchLib, 74LVC1G08GW.stp, 74LVC1G79GW,125.stp, 74LVC1G79GW_125.SchLib, EDI2CAP.CFG, SN74LVC1G04DCKR.SchLib, SN74LVC1G04DCKR.stp, SOT65P210X110-5N.PcbLib]
2025-10-18 added gnd plane fixed touch pad footprint, desiganed thermocouple amp, added ttp base ckt
    [DXF no center marks.dxf, WeighingScalePCB.kicad_pcb, WeighingScalePCB.kicad_sch, touchpad_boundary.dxf]
2025-10-27 layout done, decap placement and ferrite bead choice pending
    [WeighingScalePCB.kicad_pcb, WeighingScalePCB.kicad_sch]
2025-10-27 dvdd for loadcell updated as a pwr pour
    [WeighingScalePCB.kicad_pcb]
2025-10-27 cleared all islands and unconnected GNDs, drc and erc pending, ferrite pending, linked 3d for thermocouple amp, touchpad ic and xiao
    [WeighingScalePCB.kicad_pcb]
2025-10-28 fb removed, decaps will be sufficient, add more decaps, add cap between vbat and vcc
    [EDI2CAP.CFG, NX138AKR.SchLib, NX138AKR.stp, SOT95P230X110-3N.PcbLib, WeighingScalePCB.kicad_pcb, WeighingScalePCB.kicad_sch, chips.prt, sot95p230x110-3n.psm]
2025-10-30 dxf to be updated, start design verification document next
    [WeighingScalePCB.kicad_pcb]
2025-10-30 all 3d added
    [WeighingScalePCB.kicad_pcb]
2025-10-31 buzzer and J2 3d pending, design doc pending, edge cuts modified to remove redundant area, mounting holes are now m2 compatible
    [WeighingScalePCB.kicad_pcb, edge cuts for new mounting points.dxf]
2025-12-10 changed touch sensor to CAP1203, yet to update in layout schematic done.
    [CAP1203-1-SN.SchLib, CAP1203-1-SN.stp, EDI2CAP.CFG, SOIC127P600X175-8N.PcbLib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]
2025-12-10 added cap to threshold of 555, design 555 timer and simulate with next commit
    [WeighingScalePCB.kicad_sch]
2026-01-18 DRCs cleared
    [74LVC1G32W5-7.SchLib, 74LVC1G32W5-7.stp, EDI2CAP.CFG, SOT95P285X140-5N.PcbLib, WeighingScalePCB.kicad_pcb, WeighingScalePCB.kicad_sch, chips.prt, sot95p285x140-5n.psm]
2026-01-18 gerbers updated
    [WeighingScalePCB-B_Cu.gbr, WeighingScalePCB-B_Mask.gbr, WeighingScalePCB-B_Paste.gbr, WeighingScalePCB-B_Silkscreen.gbr, WeighingScalePCB-Edge_Cuts.gbr, WeighingScalePCB-F_Cu.gbr, WeighingScalePCB-F_Mask.gbr, WeighingScalePCB-F_Paste.gbr]
2026-01-18 version added, artwork added, gerber updated accordingly
    [WeighingScalePCB-B_Cu.gbr, WeighingScalePCB-B_Mask.gbr, WeighingScalePCB-B_Paste.gbr, WeighingScalePCB-B_Silkscreen.gbr, WeighingScalePCB-Edge_Cuts.gbr, WeighingScalePCB-F_Cu.gbr, WeighingScalePCB-F_Mask.gbr, WeighingScalePCB-F_Paste.gbr]
2026-01-18 rev added in each gerber layer
    [WeighingScalePCB-B_Cu.gbr, WeighingScalePCB-B_Mask.gbr, WeighingScalePCB-B_Paste.gbr, WeighingScalePCB-B_Silkscreen.gbr, WeighingScalePCB-Edge_Cuts.gbr, WeighingScalePCB-F_Cu.gbr, WeighingScalePCB-F_Mask.gbr, WeighingScalePCB-F_Paste.gbr]
